rokytskyii/sysprog2026test/docs/PRD.md

# Product Requirements Document (PRD)
## Мультирежимний реєстратор інцидентів (Incident Recorder: Black Box)

---

### A. Загальна ідея продукту
«Incident Recorder: Black Box» — це автономний бортовий реєстратор подій та аварійних ситуацій, спроєктований на базі мікроконтролера STM32F411RE для моніторингу умов транспортування чутливих і коштовних вантажів (Cargo mode: медичне обладнання, електроніка, оптика), а також моніторингу стаціонарних об'єктів (Site mode: опломбовані склади, серверні шафи). Пристрій функціонує за принципом доказової «чорної скриньки», фіксуючи удари, падіння, зміну просторової орієнтації, кліматичні аномалії та несанкціоноване відкриття контейнера.

При виявленні тригерної події (перевантаження, перекидання, перепад тиску або несанкціоноване освітлення) система миттєво активує модуль фотофіксації, записує телеметричні дані та субсемплований кадр у зовнішнє енергонезалежне сховище без блокування основного контуру опитування сенсорів, блокує запірний механізм за допомогою сервоприводу та виводить статус інциденту через консольний інтерфейс CLI.

---

### B. Функціональні вимоги (Functional Requirements)

* **FR-01 (Детекція ударів та перевантажень):** Система повинна опитувати інерційний сенсор MPU-6050 з частотою не менше 100 Гц і фіксувати механічні перевантаження по трьох осях (X, Y, Z) із роздільною здатністю не гірше ніж $\pm8g$.
* **FR-02 (Детекція перекидання вантажу):** Система повинна обчислювати кути нахилу (Pitch, Roll) за допомогою комплементарного фільтра та генерувати подію тривоги при відхиленні від вертикалі більше ніж на 60°.
* **FR-03 (Кліматичний та барометричний контроль):** Система повинна щосекунди вимірювати атмосферний тиск і температуру за допомогою барометра BMP180 для контролю висоти транспортування (герметичності вантажного відсіку).
* **FR-04 (Фотофіксація інциденту):** При фіксації аварійної події система повинна виконувати захоплення кадру з сенсора OV7670 протягом не більше ніж 300 мс після спрацювання тригера.
* **FR-05 (Енергонезалежне журналювання):** Система повинна циклічно зберігати метадані інцидентів (мітка часу, вектори прискорення, параметри тиску/температури) та знімок події у Flash-пам'ять W25Q64JV за допомогою неблокуючого SPI-протоколу.
* **FR-06 (Стійкість до аварійного знеструмлення):** Усі збережені у Flash-пам'яті записи та знімки повинні зберігати повну цілісність даних у разі раптового зникнення основного живлення.
* **FR-07 (Механічне пломбування контейнера):** Система повинна керувати мікросервоприводом SG92R через апаратний ШІМ-канал (TIM3 CH1, 50 Гц), переводячи фіксатор у заблокований стан (кут 180°) при переході в режим охорони («Arming»).
* **FR-08 (Консольний інтерфейс керування CLI):** Система повинна надавати двосторонній інтерфейс взаємодії через USART2 (115200 8N1) для вибору режиму роботи (`mode cargo` / `mode site`), вивантаження журналу подій (`dump log`) та програмного скидання помилок.
* **FR-09 (Світлодіодна візуалізація статусів):** Вбудований світлодіод LD2 (PA5) повинен відображати стан системи: 1 Гц миготіння — черговий режим, постійне світіння — режим охорони («Armed»), часте миготіння (10 Гц) — аварійний інцидент.
* **FR-10 (Неблокуюча архітектура підсистеми пам'яті):** Запис кадру камери у Flash-пам'ять W25Q64 не повинен блокувати таймери та обробку переривань від аварійних датчиків.

---

### C. Список датчиків та компонентів

| Модуль / Сенсор | Інтерфейс | Функціональна роль у проєкті | Альтернативи та чому їх відкинуто |
| :--- | :--- | :--- | :--- |
| **STM32 NUCLEO-F411RE** | Вбудований контролер | Центральний обчислювальний модуль (Arm Cortex-M4 @ 84 МГц), керування шинами та алгоритмами фільтрації. | **Arduino Uno (ATmega328P):** 8-бітний МК із 2 КБ RAM не здатен буферизувати навіть субсемплований кадр камери; відсутнє апаратне FPU. |
| **OmniVision OV7670** | SCCB (I2C1) + Паралельна шина (D[7:0], VSYNC, HREF, PCLK) | Обов'язкова фотофіксація обстановки під час аварійного тригера (порушення периметра, удар). | **OV5640:** має надлишковий об'єм кадру високої роздільної здатності, що потребує зовнішньої SDRAM, відсутньої на базовій платі. |
| **InvenSense MPU-6050** | I2C1 (адреса `0x68`) | 6-осьовий IMU для фіксації векторів ударного прискорення та вібраційного навантаження (FR-01, FR-02). | **Аналоговий ADXL335:** вимагає постійного опитування 3 каналів АЦП, схильний до аналогових шумів живлення, не має апаратного гіроскопа. |
| **GY-89 (BMP180, L3GD20, LSM303D)** | I2C1 (адреси `0x77`, `0x6B`, `0x1D`) | Прецизійний барометричний контроль висоти/герметичності (BMP180) та резервний магнітометр для орієнтації. | **DHT22 / BMP280:** DHT22 працює за повільним нестандартним протоколом 1-Wire (~1–2 с на вимір); модуль GY-89 об'єднує 3 датчики на одній шині. |
| **Winbond W25Q64JV** | SPI2 (PB13–PB15, CS: PB12) | Зовнішня енергонезалежна Flash-пам'ять 64 Мбіт (8 МБ) для персистентного зберігання структури чорної скриньки (FR-05, FR-06). | **Внутрішня Flash МК:** має об'єм лише 512 КБ, який виділено під код прошивки; часті цикли стирання зношують кристалічну пам'ять МК. |
| **TowerPro SG92R** | ШІМ (TIM3 CH1, 50 Гц на PA6) | Виконавчий механізм фізичного засува пломбування контейнера під час постановки на охорону (FR-07). | **Електромагнітне реле:** споживає значний постійний струм утримання, не забезпечує кутового переміщення замкового механізму. |
| **FTDI FT232RL** | UART (115200 бод) | Резервний апаратний міст для надійного вивантаження логів на зовнішній ПК у польових умовах без ST-Link. | **Bit-Bang Software UART:** генерує неприпустимий джитер тактування та перевантажує процесор ядра перериваннями. |

---

### D. План тестування та верифікації

1. **Верифікація FR-01 та FR-02 (Детекція ударів та перекидання):**
   * *Методика:* Плата піддається струшуванню з контрольованим перевищенням порогу $\pm2.5g$ та нахилу на кут >60°.
   * *Критерій успіху:* Подія удару реєструється системою протягом не більше ніж 15 мс; у UART передається тривожне повідомлення з точними координатами вектора перевантаження.
2. **Верифікація FR-03 (Кліматичний контроль):**
   * *Методика:* Зміна тиску та температури модулю GY-89; моніторинг телеметрії через PuTTY.
   * *Критерій успіху:* Зчитування вихідних регістрів BMP180 за адресою `0x77` без NACK-помилок шини; коректний перерахунок гектопаскалів у метри висоти.
3. **Верифікація FR-04 (Швидкодія фотофіксації):**
   * *Методика:* Вимірювання логічним аналізатором Saleae часового інтервалу між імпульсом переривання від MPU-6050 та початком захоплення кадрового стробу VSYNC камери.
   * *Критерій успіху:* Час від тригера до початку зчитування пікселів кадру не перевищує 300 мс.
4. **Верифікація FR-05 та FR-06 (Стійкість журналу до аварійного знеструмлення):**
   * *Методика:* Запис 100 тестових структур інцидентів у сектори W25Q64. Фізичне відключення USB-кабелю під час активного циклу опитування. Повторне подання живлення та виконання команди `dump log`.
   * *Критерій успіху:* Усі 100 записів зчитуються з флеш-пам'яті без збоїв контрольних сум (CRC) та втрати цілісності.
5. **Верифікація FR-07 (ШІМ-керування сервоприводом):**
   * *Методика:* Підключення каналу Saleae Logic до піна PA6 (TIM3 CH1). Вимірювання тривалості керівного імпульсу.
   * *Критерій успіху:* Період становить рівно 20 мс (50 Гц); тривалість імпульсу становить 1.0 мс (0° — відкрито) та 2.0 мс (180° — опломбовано).
6. **Верифікація FR-08 (Консольний інтерфейс CLI):**
   * *Методика:* Відправлення команд `help`, `status`, `mode cargo` через PuTTY на швидкості 115200 бод.
   * *Критерій успіху:* Відсутність пропущених символів при прийомі; валідна текстова відповідь системи.
