rokytskyii/sysprog2026test/docs/hardware-components.md

# Дослідження апаратних компонентів проєкту (Hardware Specification)

У цьому документі наведено детальний технічний аналіз апаратного забезпечення для лабораторної роботи №1. Усі наведені параметри (електричні рівні, адреси шин, регістрові карти, струми споживання) верифіковано за офіційними специфікаціями виробників із зазначенням конкретних сторінок та ревізій документів.

---

## 1. Зведена таблиця характеристик обладнання

| Компонент / Модуль | Офіційний документ (Ревізія) | Інтерфейс та адреса / режим | Робоча напруга | Струм споживання (активний / сон) | Ключовий регістр ID / Команда | Джерело живлення |
| :--- | :--- | :--- | :--- | :--- | :--- | :--- |
| **NUCLEO-F411RE** | ST UM1724 (Rev 17) / ST DS10314 (Rev 8) | USART2 VCP (`PA2`/`PA3`) *(UM1724 с. 26)* | 5 В (USB) $\rightarrow$ LDO 3.3 В (max **500 мА**) *(UM1724 с. 23)* | 11.6–31.5 мА (MCU @100MHz) *(DS10314 с. 72–73)* | Core-ID / UID *(DS10314 с. 1, 54)* | USB (VBUS 5V) |
| **MPU-6050** | InvenSense PS-MPU-6000A (Rev 3.1) / RM-MPU-6000A (Rev 4.0) | I2C Fast Mode (400 кГц), 7-bit `0x68` (AD0=0) *(PS с. 15, 36; RM с. 8)* | 2.375 В – 3.46 В (ном. 3.3 В) *(PS с. 8, 14)* | 3.9 мА (All ON) / 5 мкА (Sleep) *(PS с. 14)* | `WHO_AM_I` (`0x75`) = `0x68` *(RM с. 8, 46)* | Nucleo 3V3 Pin |
| **W25Q64JV** | Winbond W25Q64JV Datasheet (Rev I, 2017) | SPI Mode 0/3, SCK до 133 МГц *(DS с. 4, 11, 63)* | 2.7 В – 3.6 В (**суворо 3.3 В!**) *(DS с. 4, 59)* | 20–25 мА (Write/Erase) / 1 мкА (Power-down) *(DS с. 61)* | `JEDEC ID` (`0x9F`) = `0xEF 0x40 0x17` *(DS с. 21, 49)* | Nucleo 3V3 Pin |
| **OV7670** | OmniVision OV7670 DS (v1.01) / Software App Note | SCCB (I2C) `0x21` (`0x42`/`0x43`) + D[7:0] *(DS с. 1, 6, 10)* | Core 1.8 В, I/O 1.7–3.0 В (модуль живиться 3.3 В) *(DS с. 1, 5)* | ~18 мА (Active) / < 20 мкА (Standby) *(DS с. 1, 5)* | `PID` (`0x0A`) = `0x76`, `VER` (`0x0B`) = `0x70` *(DS с. 11)* | Nucleo 3V3 Pin |
| **GY-89: L3GD20** | ST DocID022116 (Rev 2) | I2C, 7-bit `0x6B` (SDO=1) або `0x6A` (SDO=0) *(DS с. 23)* | 2.4 В – 3.6 В *(DS с. 10)* | 6.1 мА (Active) / 5 мкА (Power-down) *(DS с. 10)* | `WHO_AM_I` (`0x0F`) = `0xD4` *(DS с. 29, 31)* | Nucleo 3V3 Pin |
| **GY-89: LSM303D** | ST DocID023312 (Rev 2) | I2C, 7-bit `0x1D` (SDO=1) або `0x1E` (SDO=0) *(DS с. 22)* | 2.16 В – 3.6 В *(DS с. 12)* | 300 мкА (Active) / 1 мкА (Power-down) *(DS с. 12)* | `WHO_AM_I` (`0x0F`) = `0x49` *(DS с. 28, 31)* | Nucleo 3V3 Pin |
| **GY-89: BMP180** | Bosch BST-BMP180-DS000-09 (Rev 2.5) | I2C, 7-bit `0x77` (`0xEE`/`0xEF`) *(DS с. 19, 20)* | 1.8 В – 3.6 В (VDDIO 1.62–3.6 В) *(DS с. 6)* | 5–32 мкА (1 sample/s) / 0.1 мкА (Standby) *(DS с. 6)* | `id` (`0xD0`) = `0x55` *(DS с. 18)* | Nucleo 3V3 Pin |
| **SG92R** | TowerPro SG92R Datasheet | PWM 50 Гц (період 20 мс, імпульс 1.0–2.0 мс) | **4.8 В – 6.0 В** (тільки 5V!) *(DS с. 1)* | 100–250 мА / Stall ~500 мА *(DS с. 1)* | Немає (керування скважністю ШІМ) | Nucleo 5V Pin (VBUS) |
| **FT232RL** | FTDI Chip DS_FT232R (v2.16) | UART (до 3 Mbaud), 115200 8N1 *(DS с. 1, 14)* | VCC 4.0–5.25 В, VCCIO 1.8–5.25 В (джампер 3.3V!) *(DS с. 15, 22)* | 15 мА (Active) / 70 мкА (Suspend) *(DS с. 15)* | Немає (апаратний USB-UART міст) | USB / VCCIO 3.3V |

---

## 2. Детальний аналіз кожного компонента

### 2.1. Плата NUCLEO-F411RE та MCU STM32F411RE
* **Документація:**
  * *STMicroelectronics UM1724 (Rev 17, Sep 2025)* — керівництво користувача плат Nucleo-64.
  * *STMicroelectronics DS10314 (Rev 8, Jan 2024)* — даташит мікроконтролера STM32F411xC/xE.
* **Архітектура ядра:** 32-бітний ARM Cortex-M4 з апаратним FPU та DSP-інструкціями, тактова частота до 100 МГц (125 DMIPS) *(DS10314, с. 1, 12, 17)*.
* **Пам'ять:** 512 КБ Flash, 128 КБ SRAM *(DS10314, с. 1, 13, 18)*.
* **Живлення плати:**
  * Плата живиться через роз'єм ST-LINK USB Mini-B (CN1, шина `U5V`) *(UM1724, Section 7.5.1, с. 21)*.
  * Вбудований лінійний LDO-регулятор (U4) формує напругу `+3.3V`. Від піна `3V3` (роз'єми CN6 пін 4 або CN7 піни 12, 16) можна живити зовнішнє навантаження струмом **до 500 мА** *(UM1724, Section 7.5.4, с. 23)*.
* **Індикація та органи керування:**
  * Зелений користувацький світлодіод `LD2`: підключений до лінії **PA5** (активний рівень HIGH) *(UM1724, Section 7.6, с. 24)*.
  * Синя кнопка користувача `B1 USER`: підключена до лінії **PC13** (підтяжка до 3.3 В, при натисканні замикає на GND) *(UM1724, Section 7.7, с. 24)*.
  * Чорна кнопка `B2 RESET`: підключена до лінії `NRST` для апаратного скидання MCU *(UM1724, Section 7.7, с. 24)*.
* **Комунікація з ПК:**
  * Вбудований відлагоджувач ST-LINK/V2-1 реалізує Virtual COM Port (VCP), підключений за замовчуванням через перемички SB13/SB14 до **USART2** (`PA2` — TX, `PA3` — RX) *(UM1724, Section 7.10, с. 26)*.
* **Призначення пінів для плати:**
  * ARDUINO-конектори CN5, CN6, CN8, CN9: конфігурація для NUCLEO-F411RE наведена в *Table 16 (с. 44–45)* *(UM1724)*.
  * ST morpho конектори CN7, CN10: повна розпіновка наведена в *Table 29 (с. 59)* *(UM1724)*.

---

### 2.2. MPU-6050 (6-DOF IMU)
* **Документація:**
  * *InvenSense PS-MPU-6000A-00 (Rev 3.1, Oct 2011)* — Product Specification.
  * *InvenSense RM-MPU-6000A-00 (Rev 4.0, Mar 2012)* — Register Map and Descriptions.
* **Інтерфейс:** I2C (Standard Mode 100 кГц, Fast Mode 400 кГц) *(PS, Section 6.4, с. 15)*.
* **Адресація:** 7-бітна адреса `b110100X`. Якщо пін `AD0` підключено до GND — адреса `0x68` (двійкова `1101000b`), якщо до 3.3 В — `0x69` (`1101001b`) *(PS, Section 6.4, с. 15; Section 9.2, с. 36; RM, Section 3, с. 8)*.
* **Живлення:** робочий діапазон VDD = 2.375 В – 3.46 В, напруга логіки VLOGIC = 1.71 В до VDD *(PS, Section 3.1, с. 8; Section 6.3, с. 14)*.
* **Струм споживання:**
  * Усі осі (акселерометр + гіроскоп) + DMP: типово **3.9 мА** *(PS, Section 6.3, с. 14)*.
  * Тільки гіроскоп: 3.6 мА *(PS, Section 5.1, с. 10; Section 6.3, с. 14)*.
  * Тільки акселерометр у звичайному режимі: 500 мкА *(PS, Section 5.2, с. 10; Section 6.3, с. 14)*.
  * Режим сну (Sleep mode): **5 мкА** *(PS, Section 5.1, с. 10; Section 6.3, с. 14)*.
* **Діапазони та чутливість:**
  * Гіроскоп: шкали $\pm250$, $\pm500$, $\pm1000$, $\pm2000$ °/с; чутливість 131, 65.5, 32.8, 16.4 LSB/(°/с) *(PS, Section 6.1, с. 12)*.
  * Акселерометр: шкали $\pm2g$, $\pm4g$, $\pm8g$, $\pm16g$; чутливість 16384, 8192, 4096, 2048 LSB/g *(PS, Section 6.2, с. 13)*.
* **Ключові регістри:**
  * `WHO_AM_I` (`0x75`): біти [6:1], повертає фіксоване значення `0x68` *(RM, Section 3, с. 8; Section 4.34, с. 46)*.
  * `PWR_MGMT_1` (`0x6B`): скид пристрою `DEVICE_RESET` (біт 7), сплячий режим `SLEEP` (біт 6, за замовчуванням 1 після подачі живлення — чіп спить!), вибір джерела тактування `CLKSEL[2:0]` (біти 2:0) *(RM, Section 3, с. 8; Section 4.30, с. 41–42)*.
  * `GYRO_CONFIG` (`0x1B`): налаштування шкали гіроскопа через біти `FS_SEL[1:0]` (біти 4:3) *(RM, Section 4.4, с. 14)*.
  * `ACCEL_CONFIG` (`0x1C`): налаштування шкали акселерометра через біти `AFS_SEL[1:0]` (біти 4:3) *(RM, Section 4.5, с. 15)*.
  * `ACCEL_XOUT_H`..`ACCEL_ZOUT_L` (`0x3B`..`0x40`): 6 байтів поточних вимірювань акселерометра *(RM, Section 4.18, с. 30)*.
  * `TEMP_OUT_H`..`TEMP_OUT_L` (`0x41`..`0x42`): 2 байти вимірювання температури *(RM, Section 4.19, с. 31)*.
  * `GYRO_XOUT_H`..`GYRO_ZOUT_L` (`0x43`..`0x48`): 6 байтів вимірювань кутової швидкості *(RM, Section 4.20, с. 32)*.

---

### 2.3. W25Q64JV (64 Mbit SPI Flash)
* **Документація:** *Winbond Electronics W25Q64JV Datasheet (Revision I, Nov 22, 2017)*.
* **Інтерфейс:** SPI Mode 0 (CPOL=0, CPHA=0) або Mode 3 (CPOL=1, CPHA=1) *(DS, Section 6.1, с. 11)*. Тактова частота SCK: до 133 МГц *(DS, Section 2, с. 4; Section 9.6, с. 63)*.
* **Живлення:** робоча напруга VCC = 2.7 В – 3.6 В *(DS, Section 2, с. 4; Section 9.2, с. 59)*. **Абсолютний максимум — 4.6 В (підключення 5 В виведе чіп з ладу!)** *(DS, Section 9.1, с. 59)*.
* **Струм споживання:**
  * Читання на частоті 50 МГц: до 15 мА *(DS, Section 9.4, с. 61)*.
  * Запис сторінки (Page Program) / Стирання (Erase): типово 20 мА, максимум **25 мА** *(DS, Section 9.4, с. 61)*.
  * Сплячий режим (Power-down): типово < 1 мкА, максимум 15 мкА *(DS, Section 2, с. 4; Section 9.4, с. 61)*.
* **Призначення виводів (SOIC-8, WSON-8):**
  * `/CS` (Pin 1): Chip Select (активний низький) *(DS, Section 3.3, с. 5; Section 4.1, с. 9)*.
  * `DO` / `IO1` (Pin 2): вихід даних MISO *(DS, Section 3.3, с. 5; Section 4.2, с. 9)*.
  * `/WP` / `IO2` (Pin 3): захист від запису (підтягнути до 3.3 В) *(DS, Section 3.3, с. 5; Section 4.3, с. 9)*.
  * `GND` (Pin 4): земля *(DS, Section 3.3, с. 5)*.
  * `DI` / `IO0` (Pin 5): вхід даних MOSI *(DS, Section 3.3, с. 5; Section 4.2, с. 9)*.
  * `CLK` (Pin 6): тактова лінія SCK *(DS, Section 3.3, с. 5; Section 4.5, с. 9)*.
  * `/HOLD` або `/RESET` / `IO3` (Pin 7): пауза інтерфейсу (підтягнути до 3.3 В) *(DS, Section 3.3, с. 5; Section 4.4, с. 9)*.
  * `VCC` (Pin 8): живлення 3.3 В *(DS, Section 3.3, с. 5)*.
* **Ключові команди (Instruction Set):**
  * `Read JEDEC ID` (`0x9F`): повертає Manufacturer ID `0xEF` (Winbond), Memory Type `0x40`, Capacity `0x17` (64 Mbit) *(DS, Section 8.1.1, с. 21; Section 8.1.2, с. 22; Section 8.3.12, с. 49)*.
  * `Write Enable` (`0x06`): встановлює біт WEL (Write Enable Latch) перед операціями запису/стирання *(DS, Section 8.1.2, с. 22; Section 8.2.1, с. 24)*.
  * `Read Status Register-1` (`0x05`): зчитування біта 0 (`BUSY`) для перевірки завершення внутрішнього циклу запису/стирання *(DS, Section 8.1.2, с. 22; Section 8.2.4, с. 25)*.
  * `Read Data` (`0x03`): послідовне читання пам'яті (до 50 МГц) *(DS, Section 8.1.2, с. 22; Section 8.2.6, с. 28)*.
  * `Page Program` (`0x02`): запис від 1 до 256 байтів у сторінку (час виконання typ 0.8 мс, max 3 мс) *(DS, Section 8.1.2, с. 22; Section 8.2.13, с. 35; Section 9.6, с. 64)*.
  * `Sector Erase (4KB)` (`0x20`): стирання сектору 4 КБ (час typ 45 мс, max 400 мс) *(DS, Section 8.1.2, с. 22; Section 8.3, с. 37; Section 9.6, с. 64)*.
  * `Block Erase (64KB)` (`0xD8`): стирання блоку 64 КБ (час typ 150 мс, max 2000 мс) *(DS, Section 8.1.2, с. 22; Section 8.3.2, с. 39; Section 9.6, с. 64)*.

---

### 2.4. Камера OV7670
* **Документація:**
  * *OmniVision Technologies OV7670/OV7171 Preliminary Datasheet (v1.01, Jul 2005)*.
  * *OmniVision Technologies OV7670 Software Application Note*.
* **Роздільна здатність:** VGA ($640\times480$ активних пікселів) *(DS, с. 1, 3)*.
* **Швидкість:** до 30 кадрів/с для формату VGA *(DS, с. 1)*.
* **Інтерфейси:**
  * Керування регістрами: шина **SCCB** (Serial Camera Control Bus), сумісна з I2C, частота тактування до 400 кГц *(DS, с. 1, 3, 6)*.
  * Адреса на шині: `0x42` (Write) / `0x43` (Read), що відповідає 7-бітній I2C адресі `0x21` *(DS, с. 10)*.
  * Передача зображення: паралельний 8-бітний порт даних `D[7:0]` + строби `VSYNC` (кадровий), `HREF` (рядковий), `PCLK` (піксельний такт) *(DS, Table 1, с. 4; Figure 5-6, с. 7)*.
* **Тактування:** сенсор потребує зовнішньої опорної частоти `XCLK`: від 10 до 48 МГц (типово 24 МГц) *(DS, Table 1, с. 4; Table 4, с. 6)*.
* **Живлення та напруги:**
  * Аналогове живлення AVDD: 2.45 В – 3.0 В (номінально 2.75 В) *(DS, Table 3, с. 5)*.
  * Цифрове ядро DVDD: 1.62 В – 1.98 В (номінально 1.8 В) *(DS, Table 3, с. 5)*.
  * Ввід/вивід DOVDD: 1.7 В – 3.0 В *(DS, Table 3, с. 5)*.
  * *Примітка:* на типовому модулі OV7670 уже розпаяні лінійні стабілізатори 2.8 В та 1.8 В, тому вся плата живиться від піна **3.3V** плати Nucleo.
* **Струм споживання:** активний робочий струм сенсора становить **18 мА** (10 мА цифрове ядро + 8 мА аналог), у режимі енергозбереження `PWDN` — менше **20 мкА** *(DS, Table 3, с. 5)*.
* **Ключові регістри:**
  * `PID` (`0x0A`): старший байт ID пристрою, повертає значення `0x76` *(DS, Table 5, с. 11)*.
  * `VER` (`0x0B`): молодший байт ID версії, повертає значення `0x70` *(DS, Table 5, с. 11)*.
  * `CLKRC` (`0x11`): налаштування внутрішнього дільника тактової частоти камери *(DS, Table 5, с. 12)*.
  * `COM7` (`0x12`): біт 7 — повний програмний скид регістрів (`0x80`); біти [5:3] — вибір роздільної здатності (VGA, CIF, QVGA, QCIF); біт 2 — вибір формату RGB; біт 0 — вибір Raw RGB *(DS, Table 5, с. 12)*.
  * `COM10` (`0x15`): конфігурація полярності вихідних стробів `PCLK`, `HREF`, `VSYNC` *(DS, Table 5, с. 13)*.
  * `COM15` (`0x40`): вибір формату RGB565 / RGB555 та вихідного діапазону даних *(DS, Table 5, с. 17)*.

---

### 2.5. Модуль GY-89 (10-DOF мультисенсор)
Плата GY-89 об'єднує три фізичні мікросхеми, підключені до спільної внутрішньої шини I2C. Модуль містить власний регулятор на 3.3 В, тому може приймати живлення 3.3–5 В на пін `VCC_IN`, але всі сигнальні лінії працюють на напрузі 3.3 В.

#### 2.5.1. L3GD20 (3-осьовий цифровий гіроскоп)
* **Документація:** *STMicroelectronics DocID022116 (Rev 2, Feb 2013)*.
* **Інтерфейс:** I2C (Standard/Fast Mode до 400 кГц) або SPI *(DS, Section 1, с. 1; Section 2.4.2, с. 12)*.
* **Адреса I2C:** 7-бітна адреса `110101xb`. Якщо пін SDO підтягнуто до Vdd_IO (на платі GY-89 за замовчуванням) — адреса `0x6B` (читання `0xD7`, запис `0xD6`). Якщо на GND — адреса `0x6A` (читання `0xD5`, запис `0xD4`) *(DS, Section 5.1.1, с. 23, Table 12)*.
* **Живлення та струм:** напруга живлення Vdd = 2.4 В – 3.6 В, Vdd_IO = 1.71 В до Vdd+0.1 В. Струм у робочому режимі: **6.1 мА**, режим сну: 2 мА, режим Power-down: **5 мкА** *(DS, Table 5, с. 10)*.
* **Шкала та чутливість:** $\pm250$, $\pm500$, $\pm2000$ dps; чутливість відповідно 8.75, 17.50, 70 mdps/digit *(DS, Table 4, с. 9)*.
* **Ключові регістри:**
  * `WHO_AM_I` (`0x0F`): повертає фіксоване значення `0xD4` (`11010100b`) *(DS, Table 17, с. 29; Section 7.1, с. 31)*.
  * `CTRL_REG1` (`0x20`): налаштування вихідної частоти ODR (`DR1:0`), смуги пропускання (`BW1:0`), увімкнення осей (`Zen, Yen, Xen`) та біт живлення `PD` (за замовчуванням `0` — режим Power-down, для роботи слід записати `1`) *(DS, Table 19-20, с. 31–32)*.
  * `CTRL_REG4` (`0x23`): вибір шкали вимірювання `FS[1:0]` та блокового оновлення `BDU` *(DS, Table 29-30, с. 34)*.
  * `OUT_X_L`..`OUT_Z_H` (`0x28`..`0x2D`): 6 регістрів вихідних даних кутових швидкостей *(DS, Table 17, с. 29; Section 7.10–7.12, с. 36)*.

#### 2.5.2. LSM303D (3-осьовий акселерометр + 3-осьовий магнітометр)
* **Документація:** *STMicroelectronics DocID023312 (Rev 2, Nov 2013)*.
* **Інтерфейс:** I2C (до 400 кГц) або SPI *(DS, Section 1, с. 1; Section 6.1, с. 21)*.
* **Адреса I2C:** 7-бітна адреса `00111xxb`. При SDO/SA0 = 1 (підтяжка на 3.3 В на платі GY-89) — адреса `0x1D` (читання `0x3B`, запис `0x3A`). При SDO/SA0 = 0 — адреса `0x1E` (читання `0x3D`, запис `0x3C`) *(DS, Section 6.1.1, с. 22, Table 11)*.
* **Живлення та струм:** Vdd = 2.16 В – 3.6 В, Vdd_IO = 1.71 В до Vdd+0.1 В. Споживання в активному режимі eCompass (акселерометр + магнітометр): типово **300 мкА**, у режимі Power-down: **1 мкА** *(DS, Table 5, с. 12)*.
* **Діапазони та чутливість:**
  * Акселерометр: шкали $\pm2g$, $\pm4g$, $\pm6g$, $\pm8g$, $\pm16g$; чутливість 0.061, 0.122, 0.183, 0.244, 0.732 mg/LSB *(DS, Table 3, с. 10)*.
  * Магнітометр: шкали $\pm2$, $\pm4$, $\pm8$, $\pm12$ gauss; чутливість 0.080, 0.160, 0.320, 0.479 mgauss/LSB *(DS, Table 3, с. 10)*.
* **Ключові регістри:**
  * `WHO_AM_I` (`0x0F`): повертає фіксований ідентифікатор `0x49` (`01001001b`) *(DS, Table 16, с. 28; Section 8.6, с. 31)*.
  * `CTRL1` (`0x20`): вибір частоти оновлення акселерометра `AODR[3:0]` (значення `0000b` — вимкнено), біт `BDU`, увімкнення осей `AXEN`, `AYEN`, `AZEN` *(DS, Table 34–36, с. 34–35)*.
  * `CTRL2` (`0x21`): вибір повної шкали акселерометра `AFS[2:0]` *(DS, Table 37, 40, с. 35–36)*.
  * `CTRL5` (`0x24`): увімкнення сенсора температури `TEMP_EN`, роздільна здатність магнітометра `M_RES[1:0]`, частота магнітометра `M_ODR[2:0]` *(DS, Table 45–47, с. 37–38)*.
  * `CTRL6` (`0x25`): вибір шкали магнітометра `MFS[1:0]` *(DS, Table 48, 50, с. 38)*.
  * `CTRL7` (`0x26`): вибір режиму магнітометра `MD[1:0]` (значення `00b` — безперервне вимірювання, `01b` — одиночне, `10b`/`11b` — вимкнено) *(DS, Table 51, 54, с. 38–39)*.
  * `OUT_X_L_A`..`OUT_Z_H_A` (`0x28`..`0x2D`): 6 регістрів даних акселерометра *(DS, Section 8.25–8.27, с. 40)*.
  * `OUT_X_L_M`..`OUT_Z_H_M` (`0x08`..`0x0D`): 6 регістрів даних магнітометра *(DS, Section 8.3–8.5, с. 31)*.

#### 2.5.3. BMP180 (цифровий барометричний датчик тиску та температури)
* **Документація:** *Bosch Sensortec BST-BMP180-DS000-09 (Revision 2.5, Apr 2013)*.
* **Інтерфейс:** I2C (Standard, Fast, High-Speed mode до 3.4 МГц) *(DS, Section 5, с. 19; Table 6, с. 19)*.
* **Адреса I2C:** фіксована 7-бітна адреса `1110111b` = `0x77` (байт запису `0xEE`, байт читання `0xEF`) *(DS, Section 5.2, с. 20, Table 7)*.
* **Живлення та струм:** VDD = 1.8 В – 3.6 В (типово 2.5 В), VDDIO = 1.62 В – 3.6 В *(DS, Table 1, с. 6)*.
  * Струм при 1 вимірюванні на секунду: 3 мкА (ultra low power), 5 мкА (standard), 12 мкА (ultra high resolution) *(DS, Table 1, с. 6; Table 3, с. 12)*.
  * Струм у режимі очікування (Standby): **0.1 мкА** *(DS, Table 1, с. 6)*.
  * Піковий струм перетворення тиску: типово 650 мкА, максимум 1000 мкА *(DS, Table 1, с. 6)*.
* **Час перетворення:** температура — максимум 4.5 мс; тиск — від 4.5 мс (режим 0) до 25.5 мс (режим 3) *(DS, Table 1, с. 7; Table 8, с. 21)*.
* **Ключові регістри:**
  * `id` (`0xD0`): фіксоване значення чіпа `0x55` *(DS, Section 4, с. 18, Figure 6)*.
  * `soft reset` (`0xE0`): запис значення `0xB6` викликає повне програмне перезавантаження чіпа *(DS, Section 4, с. 18)*.
  * `ctrl_meas` (`0xF4`): регістр запуску вимірювання. Біт 5 (`sco`) дорівнює 1 під час перетворення. Запис `0x2E` запускає вимірювання температури, запис `0x34 + (oss << 6)` запускає вимірювання тиску з оверсемплінгом `oss` *(DS, Section 4, с. 18; Section 5.4, с. 21, Table 8)*.
  * `out_msb` (`0xF6`), `out_lsb` (`0xF7`), `out_xlsb` (`0xF8`): регістри результату АЦП (16–19 бітів) *(DS, Section 4, с. 18; Section 5.5, с. 22)*.
  * Регістри калібрування `0xAA`..`0xBF`: 11 індивідуальних 16-бітних коефіцієнтів (AC1..AC6, B1, B2, MB, MC, MD) для обчислення скоригованого тиску й температури за поліноміальним алгоритмом *(DS, Section 3.4, с. 13, Table 5; Section 3.5, с. 14–15)*.

---

### 2.6. Сервопривід SG92R
* **Документація:** *TowerPro SG92R Specification Sheet*.
* **Інтерфейс:** апаратний ШІМ (PWM) керування кутом повороту:
  * Частота керівного сигналу: 50 Гц (період 20 мс) *(DS, с. 1)*.
  * Тривалість керівного імпульсу: ~1.0 мс (кут 0°), ~1.5 мс (кут 90°, нейтраль), ~2.0 мс (кут 180°).
  * Ширина мертвої зони (Dead Band Width): 1 мкс *(DS, с. 1)*.
* **Живлення та навантаження:**
  * Робоча напруга: **4.8 В – 6.0 В** (номінально 4.8 В) *(DS, с. 1)*.
  * Зусилля (Stall Torque): 2.5 кг/см при напрузі 4.8 В *(DS, с. 1)*.
  * Швидкість повороту: 0.1 с / 60° при 4.8 В *(DS, с. 1)*.
* **Струм споживання:** холостий хід — 100–250 мА, пусковий струм і струм блокування ротора (Stall Current) — **до 500 мА** *(DS, с. 1)*.
* **Критична вимога підключення:** підключати виключно до лінії **5V (USB VBUS)**. Підключення до лінії 3.3 В суворо заборонено через високі імпульсні просідання струму.

---

### 2.7. Модуль FT232RL (USB-to-UART Converter)
* **Документація:** *FTDI Chip FT232R USB UART IC Datasheet (DS_FT232R Version 2.16)*.
* **Інтерфейс:** асинхронний прийомопередавач UART (TXD/RXD) *(DS, Section 1, с. 1; Section 3.2, с. 7)*.
* **Швидкість:** від 300 бод до 3 Мбод (для роботи використовується стандартна 115200 8N1) *(DS, Section 1, с. 1; Section 4.2, с. 14)*.
* **Живлення та електричні параметри:**
  * Живлення ядра VCC: 4.0 В – 5.25 В (при роботі від внутрішнього генератора) *(DS, Table 5.2, с. 15)*.
  * Живлення порту вводу-виводу VCCIO: від 1.8 В до 5.25 В *(DS, Table 3.2, с. 7; Table 5.2, с. 15)*.
  * Вбудований регулятор 3.3 В (пін 17 `3V3OUT`): вихідна напруга 3.0–3.6 В, допустимий вихідний струм до 50 мА *(DS, Table 3.2, с. 7; Table 5.2, с. 15)*.
  * Струм споживання: активний режим — типово **15 мА**, сплячий режим USB Suspend — **70 мкА** *(DS, Table 5.2, с. 15)*.
* **Конфігурація підключення:**
  * `TXD` (Pin 1) $\rightarrow$ `RX` мікроконтролера STM32 *(DS, Table 3.4, с. 8)*.
  * `RXD` (Pin 5) $\leftarrow$ `TX` мікроконтролера STM32 *(DS, Table 3.4, с. 8)*.
  * `GND` (Pins 7, 18, 21): спільна земля *(DS, Table 3.2, с. 7)*.
  * **Критичне налаштування перемикача:** джампер вибору рівня напруги логіки на платі адаптера обов'язково встановлюється у положення **3.3V** (з'єднує VCCIO з піном 3V3OUT). Це унеможливлює потрапляння напруги 5 В на виводи STM32 *(DS, Section 6.4, с. 22)*.

---

## 3. Розрахунок бюджету живлення (Power Budget)

1. **Можливості плати NUCLEO-F411RE:**
   * Вбудований LDO LD39050PU33R забезпечує максимальний струм до **500 мА** на шині 3.3 В *(UM1724, Section 7.5.4, с. 23)*.
   * Власне споживання мікроконтролера STM32F411RE на частоті 100 МГц (з периферією): **~22–32 мА** *(DS10314, Table 22, с. 71; Table 24, с. 73)*.
2. **Споживання периферії на лінії 3.3 В у піковому навантаженні:**
   * MPU-6050 (усі сенсори + DMP активні): **3.9 мА** *(PS-MPU-6000A, Section 6.3, с. 14)*.
   * Модуль GY-89 (L3GD20 + LSM303D + BMP180): $6.1\text{ мА} + 0.3\text{ мА} + 0.03\text{ мА} \approx \mathbf{6.43\text{ мА}}$ *(DocID022116 с. 10; DocID023312 с. 12; BST-BMP180 с. 6)*.
   * W25Q64JV (режим програмування/стирання): **25 мА** максимум *(W25Q64JV DS, Section 9.4, с. 61)*.
   * OV7670 (захоплення кадру VGA): **~18–20 мА** *(OV7670 DS, Table 3, с. 5)*.
   * FT232RL (активна передача даних по UART): **15 мА** *(DS_FT232R, Table 5.2, с. 15)*.
   * **Сумарне споживання лінії 3.3 В:** $32 + 3.9 + 6.43 + 25 + 20 + 15 \approx \mathbf{102.3\text{ мА}}$.
   * **Висновок:** Загальне споживання становить менше 21% від ліміту стабілізатора плати (500 мА). Живлення сенсорів і модулів безпосередньо від піна `3V3` Nucleo є безпечним і не призведе до перегріву або просідання напруги.
3. **Особливості живлення сервоприводу SG92R:**
   * Пусковий струм та струм під навантаженням: **до 500 мА** при 4.8 В *(SG92R DS, с. 1)*.
   * **Висновок:** Сервопривід підключається **виключно до шини 5V (USB VBUS)**. Підключення до лінії 3.3 В суворо заборонено, оскільки це викличе просідання напруги нижче 1.7 В і спрацювання схеми захисту BOR (Brown-Out Reset) мікроконтролера STM32 *(DS10314, Section 3.15.1, с. 22; Table 19, с. 67)*.
