rokytskyii/sysprog2026test/(commit log)

2026-10-03 step6 (previous step6 was a mistake)
    [firmware.ioc, main.c, main.h]
2026-10-16 components connected, UART1 turned on, tests in main
